MonFrancoue/swr_power_meter/src/hw/TOSMETRE.sch

## KiCad design src/hw/TOSMETRE.sch (2021-02-22)

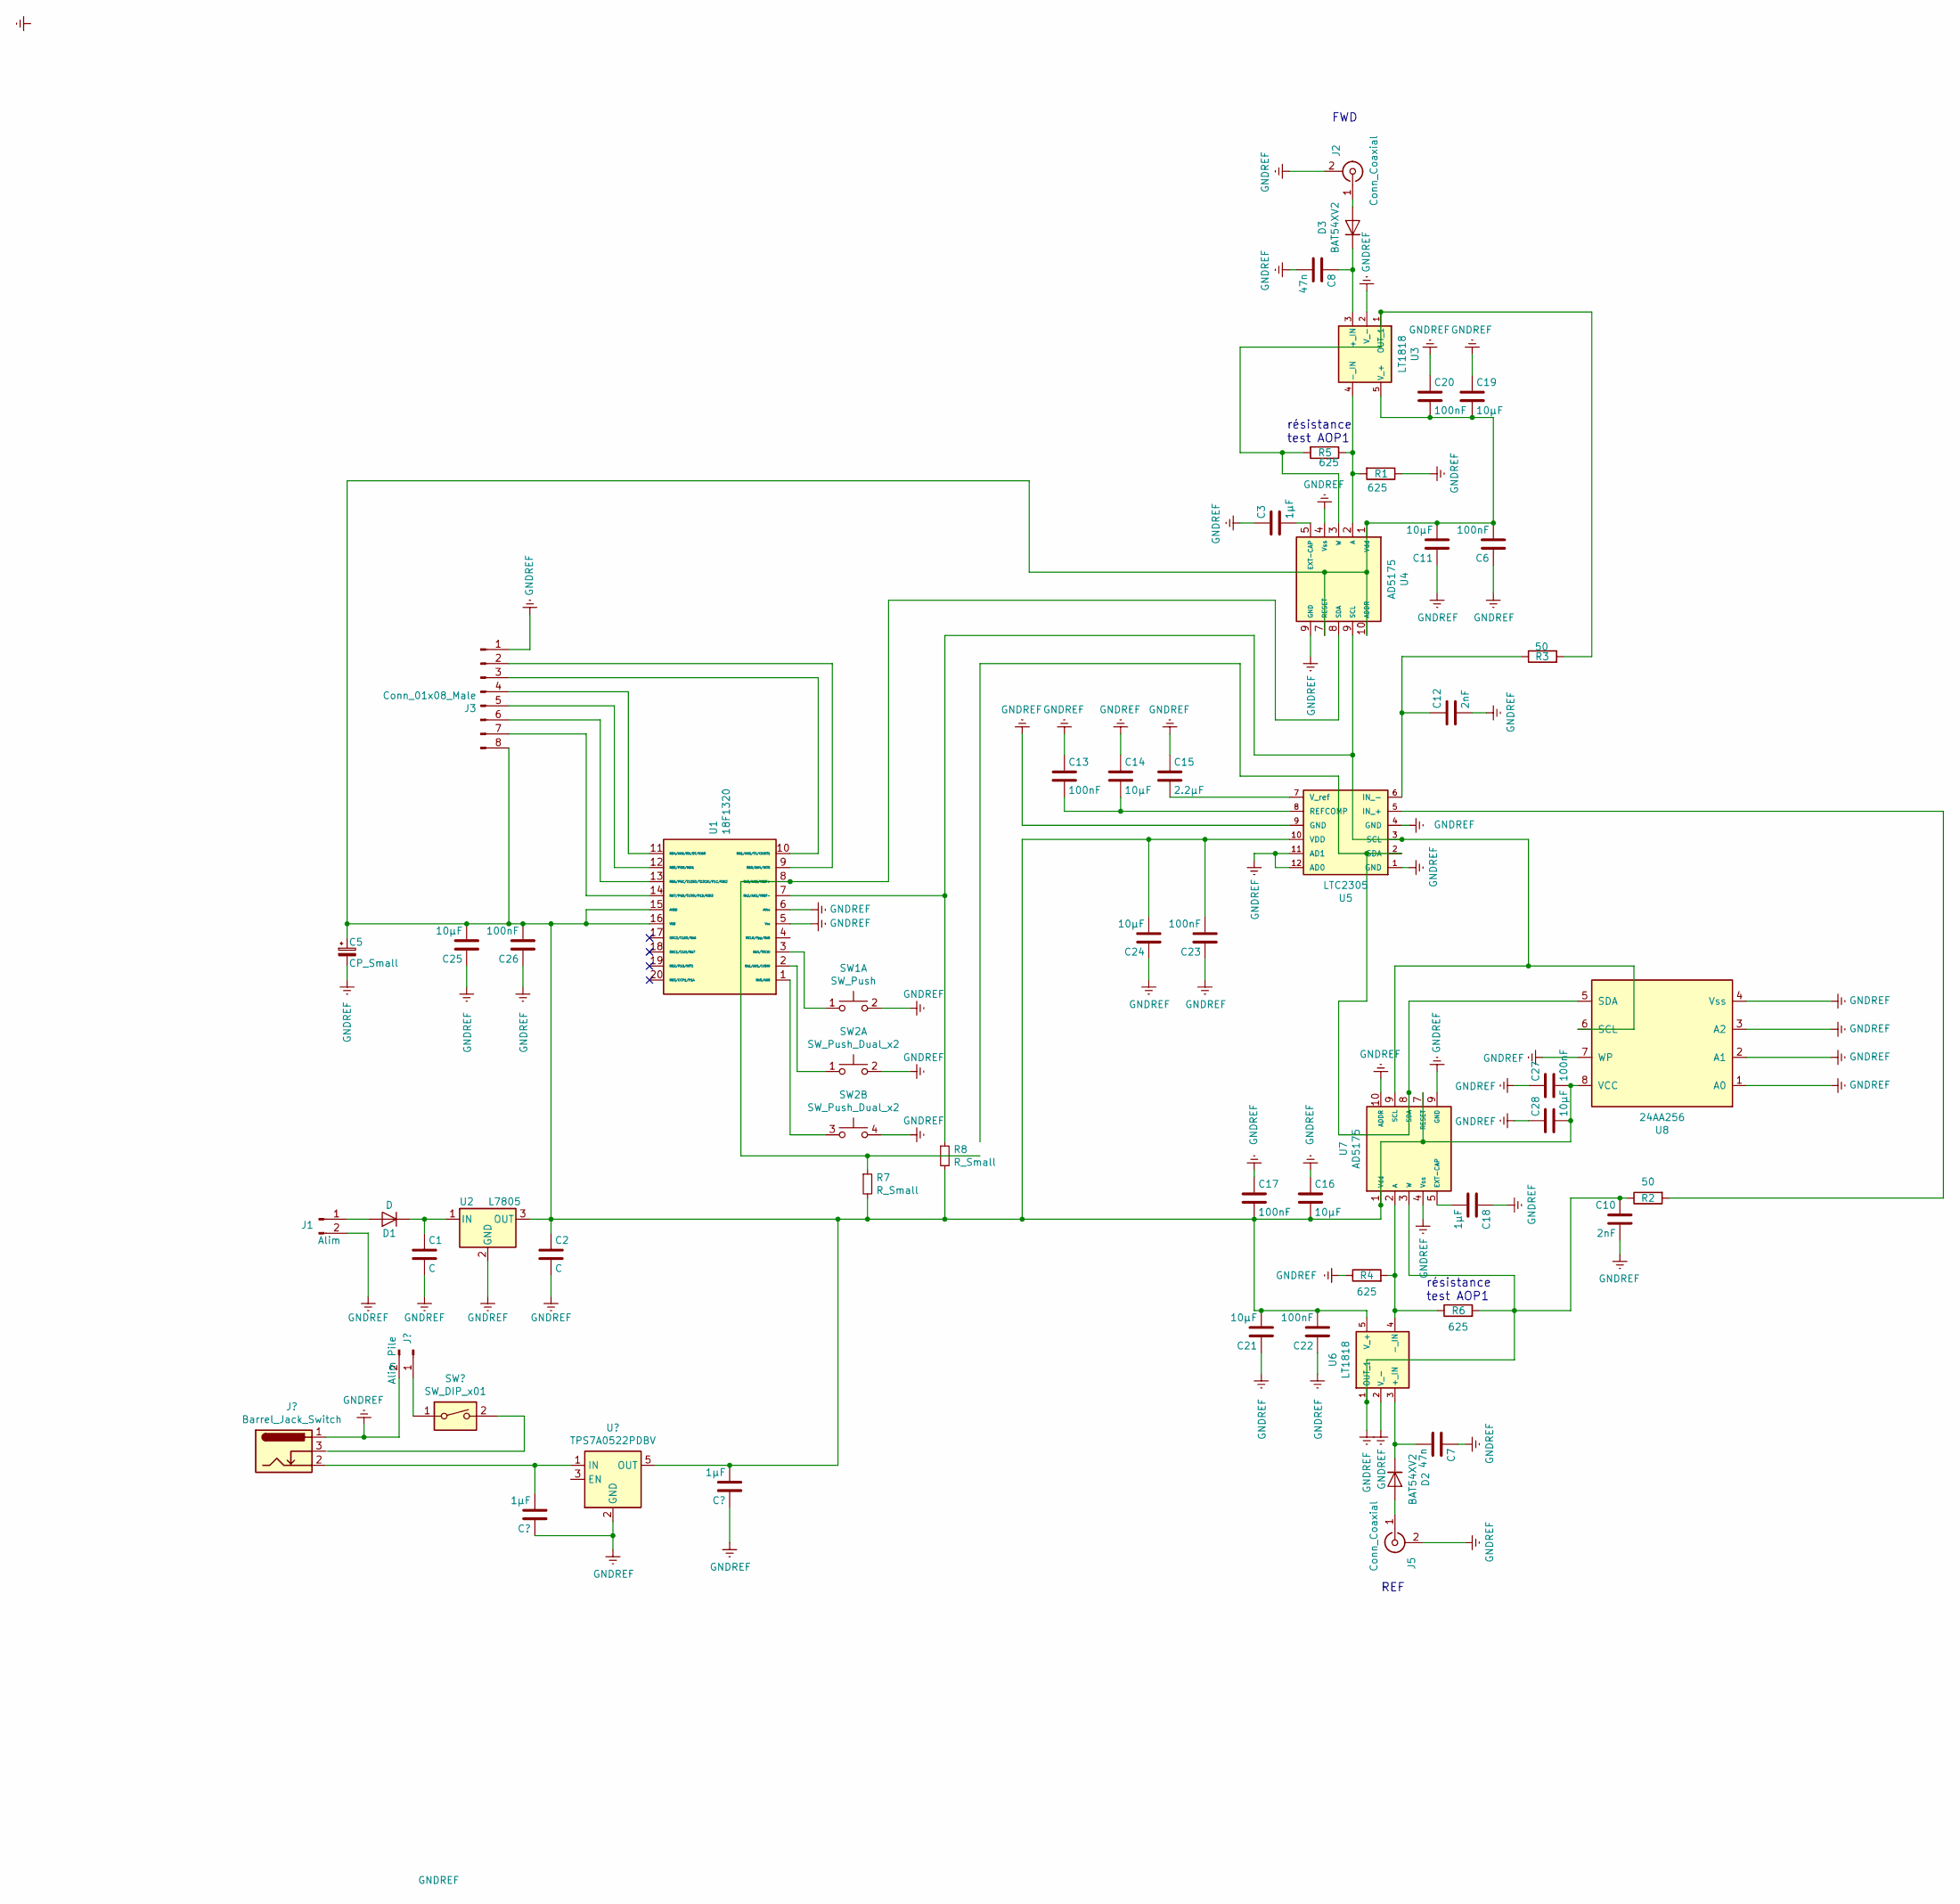
[picture p30: schematic TOSMETRE.sch]

Parts:
C1, C2: C; C_1206_3216Metric
C3, C18: 1µF; C_1206_3216Metric
C5: CP_Small; C_1206_3216Metric
C6, C13, C17, C20, C22, C23, C26, C27: 100nF; C_1206_3216Metric
C7, C8: 47n; C_1206_3216Metric
C10, C12: 2nF; C_1206_3216Metric
C11, C14, C16, C19, C21, C24, C25, C28: 10µF; C_1206_3216Metric
C15: 2.2µF; C_1206_3216Metric
D1: D; C_1206_3216Metric
D2, D3: BAT54XV2; D_SOD-523
J1: Alim; PinHeader_1x02_P2.54mm_Vertical
J2, J5: Conn_Coaxial; SMA_Amphenol_132203-12_Horizontal
J3: Conn_01x08_Male; PinHeader_1x08_P2.00mm_Vertical
R1, R4, R5, R6: 625; R_1206_3216Metric
R2, R3: 50; R_1206_3216Metric
R7, R8: R_Small; R_1206_3216Metric
SW1: SW_Push; SW_Push_1P1T-SH_NO_CK_KMR2xxG
SW2: SW_Push_Dual_x2; SW_Push_1P1T-SH_NO_CK_KMR2xxG
U1: 18F1320; SSOP-20_4.4x6.5mm_P0.65mm
U2: L7805; TO-220-3_Horizontal_TabDown
U3, U6: LT1818; TSOT-23-5
U4, U7: AD5175; MSOP-10_3x3mm_P0.5mm
U5: LTC2305; MSOP-8_3x3mm_P0.65mm
U8: 24AA256; TSSOP-8_4.4x3mm_P0.65mm

Connections:
GNDREF: C1.2, C2.2, C3.1, C5.2, C6.1, C7.1, C8.2, C10.1, C10.2, C11.1, C12.2, C13.1, C14.1, C15.1, C16.1, C17.1, C18.1, C19.1, C20.1, C21.1, C22.1, C23.1, C24.1, C25.1, C26.1, C27.1, C28.1, J1.2, J2.2 (Ext), J3.1, J5.2 (Ext), R1.1, R2.1, R4.1, R6.2, SW1.2 (D), SW2.2 (D), SW2.4 (D), U1.5 (Vss), U1.6 (AVss), U2.2 (GND), U3.2 (V_-), U4.4 (Vss), U4.9 (GND), U5.1 (GND), U5.4 (GND), U5.9 (GND), U5.11 (AD1), U5.12 (AD0), U6.1 (OUT_1), U6.2 (V_-), U7.3 (W), U7.4 (Vss), U7.9 (GND), U7.10 (ADDR), U8.1 (A0), U8.2 (A1), U8.3 (A2), U8.4 (Vss), U8.7 (WP)
unnamed: C1.1, D1.1 (K), U2.1 (IN)
unnamed: C3.2, U4.5 (EXT-CAP)
unnamed: C7.2, D2.1 (K), U6.3 (+_IN)
unnamed: C8.1, D3.1 (K), U3.3 (+_IN)
unnamed: C2.1, C5.1, C6.2, C11.2, C16.2, C17.2, C19.2, C20.2, C21.2, C22.2, C23.2, C24.2, C25.2, C26.2, C27.2, C28.2, J3.8, R7.2, R8.2, U1.15 (AVDD), U1.16 (VDD), U2.3 (OUT), U3.5 (V_+), U4.1 (Vdd), U4.7 (RESET), U4.10 (ADDR), U5.10 (VDD), U6.5 (V_+), U7.1 (Vdd), U7.7 (RESET), U8.8 (VCC)
unnamed: C12.1, R3.1, U5.6 (IN_-)
unnamed: C13.2, C14.2, U5.8 (REFCOMP)
unnamed: C15.2, U5.7 (V_ref)
unnamed: C18.2, U7.5 (EXT-CAP)
unnamed: D1.2 (A), J1.1
unnamed: D2.2 (A), J5.1 (In)
unnamed: D3.2 (A), J2.1 (In)
unnamed: J3.2, U1.9 (RB0/AN4/INT0)
unnamed: J3.3, U1.10 (RB1/AN5/TX/CKINT1)
unnamed: J3.4, U1.11 (RB4/AN6/RX/DT/KIB0)
unnamed: J3.5, U1.12 (RB5/PGM/KBI1)
unnamed: J3.6, U1.13 (RB6/PGC/T1OSO/T13CKI/P1C/KBI2)
unnamed: J3.7, U1.14 (RB7/PGD/T1OSI/P1D/KBI3)
unnamed: R1.2, R5.1, U3.4 (-_IN), U4.2 (A)
unnamed: R2.2, U5.5 (IN_+)
unnamed: R3.2, R5.2, U3.1 (OUT_1), U4.3 (W)
unnamed: R4.2, R6.1, U6.4 (-_IN), U7.2 (A)
unnamed: R7.1, U1.8 (RA3/AN3/VREF+), U4.8 (SDA)
unnamed: R8.1, U1.7 (RA2/AN2/VREF-), U4.9 (GND), U5.3 (SCL), U7.9 (GND), U8.6 (SCL)
unnamed: SW1.1 (C), U1.3 (RA4/T0CKI)
unnamed: SW2.1 (C), U1.2 (RA1/AN1/LVDIN)
unnamed: SW2.3 (C), U1.1 (RA0/AN0)
unnamed: U5.2 (SDA), U7.8 (SDA), U8.5 (SDA)

Notes on the sheet:
REF
FWD
résistance test AOP1
